EwoudVV/pcb-vise/HARDWARE.md

# hardware for one vise

this is the hardware for the general-purpose vise with TPU edge grips. the optional ESC attachment has its own [extra parts list](hardware-esc.csv)

the standard parts come to $46.31, or about $70.13 delivered with estimated tax. individual links and prices are in [hardware.csv](hardware.csv). `Quantity` is what goes in the vise; `Buy_quantity` is what to order

| Part | Qty |
| --- | ---: |
| M5 x 35 socket cap screw DIN 912 | 8 |
| M5 washer, 10 mm OD x 1 mm | 8 |
| M5 nut DIN 934, 8 mm AF x 4 mm | 8 |
| M3 x 30 socket cap screw DIN 912 | 8 |
| M3 nut DIN 934, 5.5 mm AF x 2.4 mm | 12 |
| M4 x 12 socket cap screw DIN 912 | 4 |
| M4 nut DIN 934, 7 mm AF x 3.2 mm | 6 |
| M6 x 50 hex bolt DIN 933 | 2 |
| M6 washer, 12 mm OD x 1.6 mm | 2 |
| M6 nut DIN 934, 10 mm AF x 5 mm | 2 |
| 8 x 250 mm smooth steel rod | 2 |
| M4 x 50 socket cap screw DIN 912 | 2 |
| M4 washer, 9 mm OD x 0.8 mm | 2 |
| Steel ballast, 38.1 x 60 x 19.05 mm | 4 |
| M3 x 20 socket cap screw DIN 912 | 4 |

## optional ESC attachment

the two printed adapters need eight M3 x 25 screws, four extra M3 nuts and four M3 washers. the nuts already fitted in the jaws are reused. those extra fasteners cost $1.12 before shipping and tax

use the longer screws with the ESC adapters. the standard edge grips use M3 x 20 screws

## check before ordering

use the nut sizes below. taller nuts, including Nylocs, won't fit the pockets

| Nut | Across flats | Height | Pocket across flats |
| --- | ---: | ---: | ---: |
| M3 | 5.5 mm | 2.4 mm | 5.8 mm |
| M4 | 7 mm | 3.2 mm | 7.3 mm |
| M5 | 8 mm | 4 mm | 8.3 mm |
| M6 | 10 mm | 5 mm | 10.3 mm |

the M5 pockets are only 4.4 mm deep, so a 4.7 mm tall nut won't work. check the actual hardware with the fit samples before printing all the parts. screw lengths are measured from under the head

## ballast

order four supplied-cut pieces of 3/4 x 1 1/2 inch 1018 steel bar, each 2.362 inches long (about 60 mm). the [custom-cut quote](https://www.onlinemetals.com/en/buy/carbon-steel/0-75-x-1-5-carbon-steel-rectangle-bar-1018-cold-finish/pid/9720) is $5.98 each

the supplier allows +1/8 inch and no undersize on the cut length. the liners now have 64 mm inside length and the foot pockets are 67 mm long, so pieces up to 63.17 mm fit. file any sharp burrs before fitting them. no sawing is planned

[ballast drawing](drawings/feet-and-ballast.svg) · [base calculation notes](DESIGN.md)

## references

- [DIN 934 nut dimensions](https://www.westfieldfasteners.co.uk/Standards/Nut_Hex_M.html)
- [DIN 912 cap screw dimensions](https://www.boltking.co.uk/din-912)
- [guide rod pair](https://www.walmart.com/ip/5057851455)

## prices checked October 15

| Order | Parts | Shipping | Tax | Total |
| --- | ---: | ---: | ---: | ---: |
| Bolt Depot standard fasteners | $7.90 | $7.33 | $0.49 | $15.72 |
| Online Metals, four cut weights | $23.92 | $13.59 | $1.50 | $39.01 |
| Walmart / Tasharina, rod pair | $14.49 | free | $0.91 estimated | $15.40 estimated |
| Total | $46.31 | $20.92 | $2.90 | $70.13 |

quotes use 01776 and residential shipping. Walmart shows free shipping but calculates tax at checkout; the $0.91 estimate uses [Massachusetts' 6.25% rate](https://www.mass.gov/guides/sales-and-use-tax)

one $5.98 weight is self-funded on the Half Life website, making its funding list $64.15. all four weights are required and are included in this file, the CSV and the cart

PETG-CF and TPU for AMS are already owned. the coupons tried did not lower the quoted total. nothing ordered yet
