EwoudVV/pcb-vise/exports/ballast-detail.png

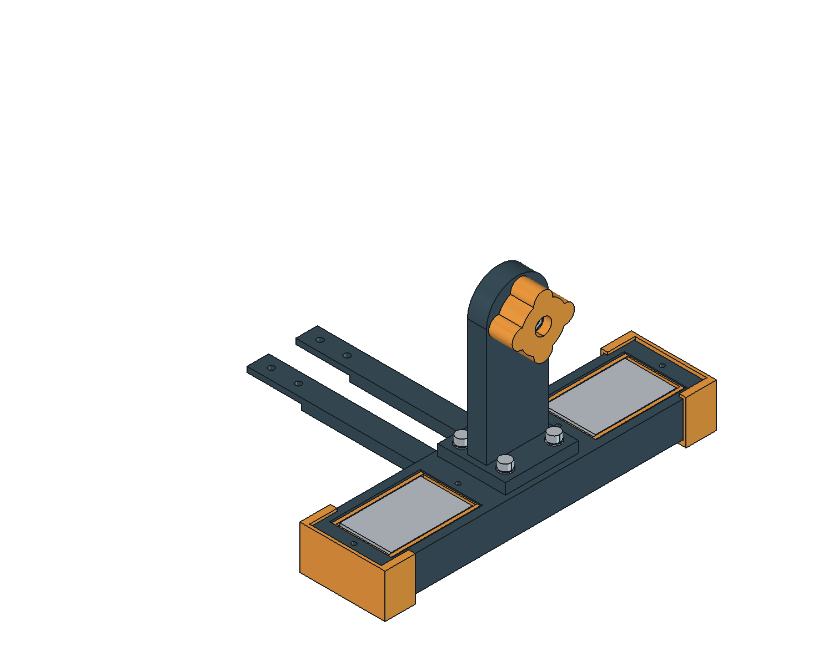
exports/ballast-detail.png
