EwoudVV/pcb-vise/exports/edge-grips.png

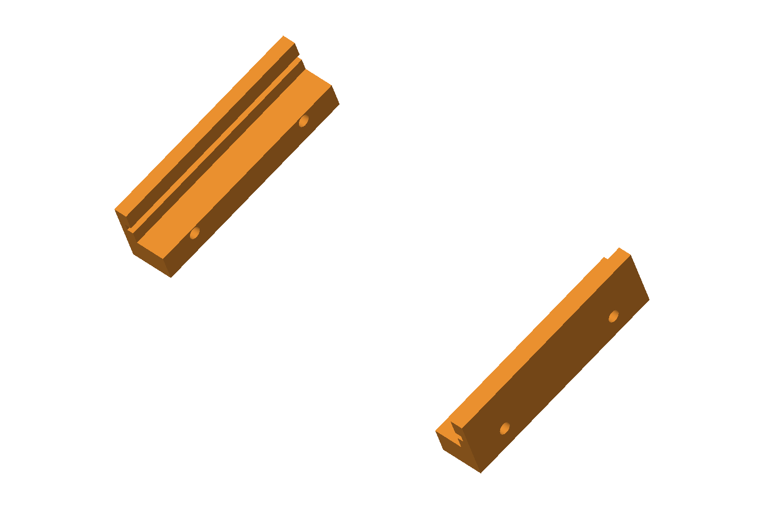
exports/edge-grips.png
