EwoudVV/pcb-vise/exports/underside-preview.png

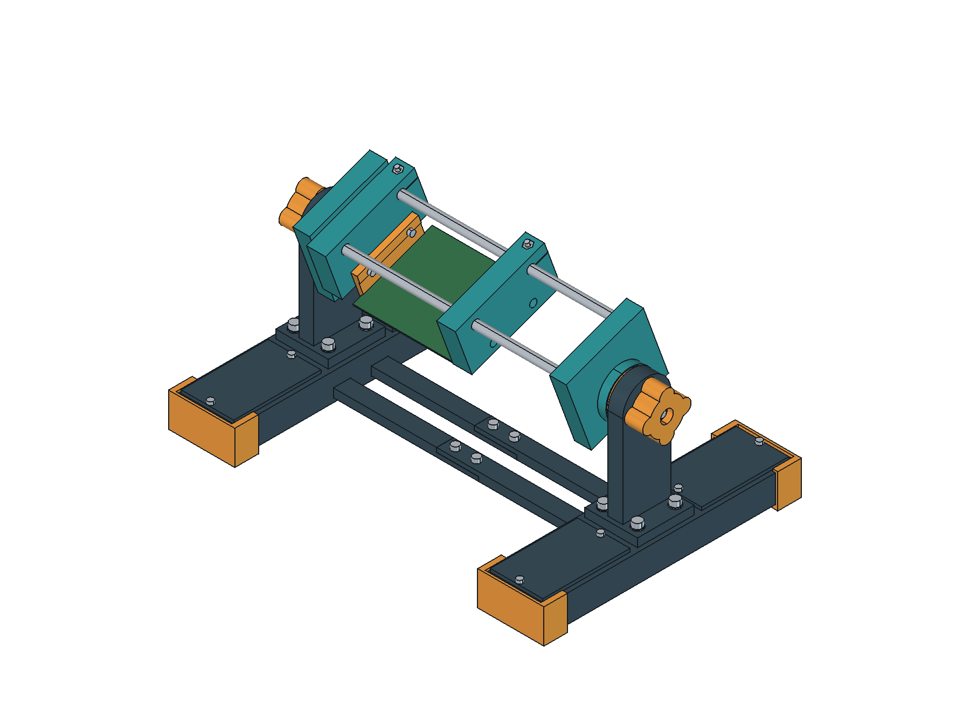
exports/underside-preview.png
