EwoudVV/pcb-vise/BOM.csv

Item | Qty | Supplier | Cost/item | Total Cost | link
M5 x 35 socket cap screw DIN 912 | 8 | Bolt Depot | $0.29 | $2.32 | https://boltdepot.com/Product-Details?product=6413
M5 washer, 10 mm OD x 1 mm | 8 | Bolt Depot | $0.05 | $0.40 | https://boltdepot.com/Product-Details?product=4515
M5 nut DIN 934, 8 mm AF x 4 mm | 8 | Bolt Depot | $0.07 | $0.56 | https://boltdepot.com/Product-Details?product=4775
M3 x 30 socket cap screw DIN 912 | 8 | Bolt Depot | $0.10 | $0.80 | https://boltdepot.com/Product-Details?product=6385
M3 nut DIN 934, 5.5 mm AF x 2.4 mm | 12 | Bolt Depot | $0.07 | $0.84 | https://boltdepot.com/Product-Details?product=4773
M4 x 12 socket cap screw DIN 912 | 4 | Bolt Depot | $0.09 | $0.36 | https://boltdepot.com/Product-Details?product=6394
M4 nut DIN 934, 7 mm AF x 3.2 mm | 6 | Bolt Depot | $0.07 | $0.42 | https://boltdepot.com/Product-Details?product=4774
M6 x 50 hex bolt DIN 933 | 2 | Bolt Depot | $0.45 | $0.90 | https://boltdepot.com/Product-Details?product=5971
M6 washer, 12 mm OD x 1.6 mm | 2 | Bolt Depot | $0.06 | $0.12 | https://boltdepot.com/Product-Details?product=4516
M6 nut DIN 934, 10 mm AF x 5 mm | 2 | Bolt Depot | $0.11 | $0.22 | https://boltdepot.com/Product-Details?product=4776
M4 x 50 socket cap screw DIN 912 | 2 | Bolt Depot | $0.29 | $0.58 | https://boltdepot.com/Product-Details?product=6404
M4 washer, 9 mm OD x 0.8 mm | 2 | Bolt Depot | $0.05 | $0.10 | https://boltdepot.com/Product-Details?product=4514
M3 x 20 socket cap screw DIN 912 | 4 | Bolt Depot | $0.07 | $0.28 | https://boltdepot.com/Product-Details?product=6383
8 x 250 mm steel guide rods, pair | 1 | Walmart / Tasharina Corp | $14.49 | $14.49 | https://www.walmart.com/ip/5057851455
Steel ballast blocks (3 funded of 4) | 3 | Online Metals | $5.98 | $17.94 | https://www.onlinemetals.com/en/buy/carbon-steel/0-75-x-1-5-carbon-steel-rectangle-bar-1018-cold-finish/pid/9720
Estimated total shipping | 1 |  |  | $23.82
