EwoudVV/pcb-vise/cad/pcb-vise-edge-grips.FCStd

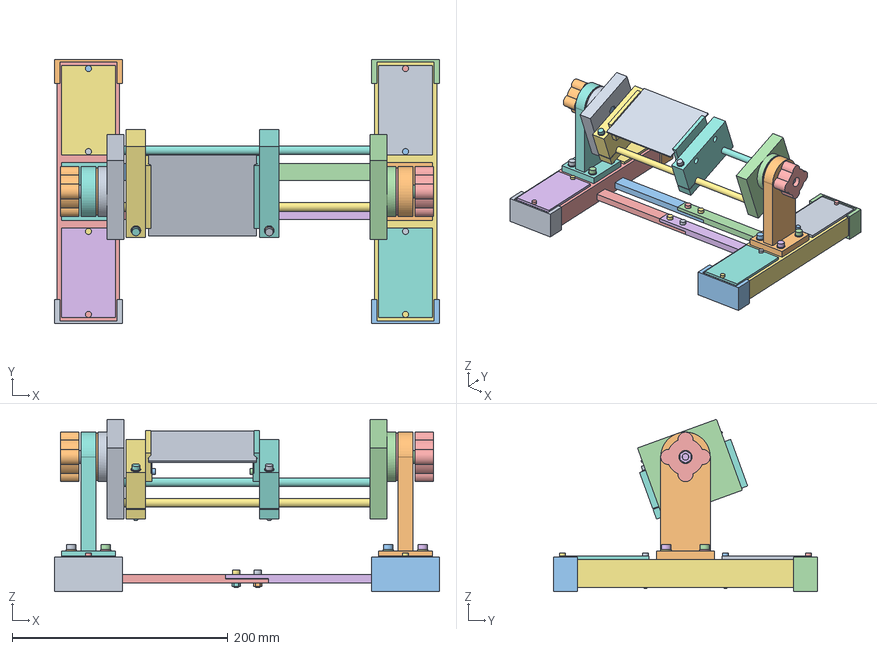
[picture p6: CAD file, 2026-10-15]
cad/pcb-vise-edge-grips.FCStd
357.0 x 245.0 x 160.0 mm
LeftBaseScrew0
LeftBaseWasher0
LeftBaseNut0
LeftBaseScrew1
LeftBaseWasher1
LeftBaseNut1
LeftBaseScrew2
LeftBaseWasher2
LeftBaseNut2
LeftBaseScrew3
LeftBaseWasher3
LeftBaseNut3
LeftLidScrew_114
LeftLidNut_114
LeftLidScrew_37
LeftLidNut_37
LeftLidScrew37
LeftLidNut37
LeftLidScrew114
LeftLidNut114
LeftFoot
LeftFrontBallastLid
LeftRearBallastLid
LeftUpright
LeftFrontShoe
LeftRearShoe
RightBaseScrew0
RightBaseWasher0
RightBaseNut0
RightBaseScrew1
RightBaseWasher1
RightBaseNut1
RightBaseScrew2
RightBaseWasher2
RightBaseNut2
RightBaseScrew3
RightBaseWasher3
RightBaseNut3
RightLidScrew_114
RightLidNut_114
RightLidScrew_37
RightLidNut_37
RightLidScrew37
RightLidNut37
RightLidScrew114
RightLidNut114
RightFoot
RightFrontBallastLid
RightRearBallastLid
RightUpright
RightFrontShoe
RightRearShoe
LeftFrontTie
RightFrontTie
FrontJointScrew0
FrontJointNut0
FrontJointScrew1
FrontJointNut1
LeftRearTie
RightRearTie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
