EwoudVV/pcb-vise/exports/fit-tests/m3-m4-m5-fit.stl

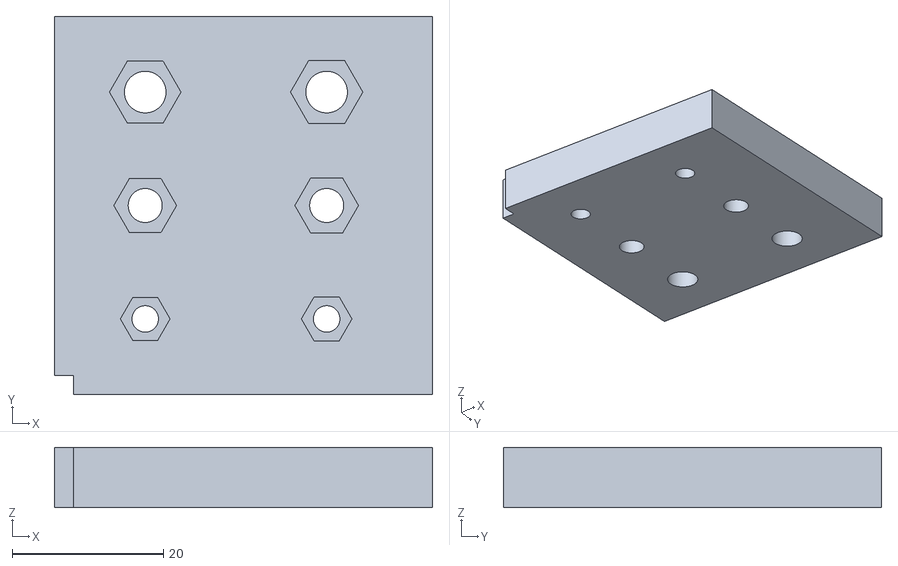
[picture p7: CAD file, 2026-10-14]
exports/fit-tests/m3-m4-m5-fit.stl
50.0 x 50.0 x 8.00
