EwoudVV/pcb-vise/exports/parts/LeftRearBallastLiner.stl

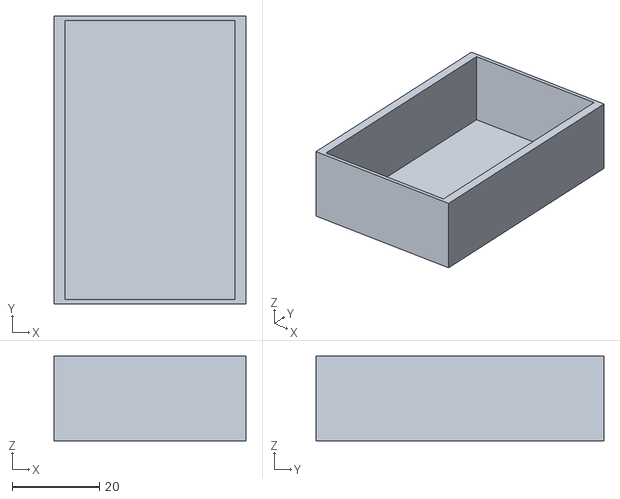
[picture p8: CAD file, 2026-10-15]
exports/parts/LeftRearBallastLiner.stl
44.0 x 66.0 x 19.5
