EwoudVV/pcb-vise/exports/print-plates/01-feet.3mf

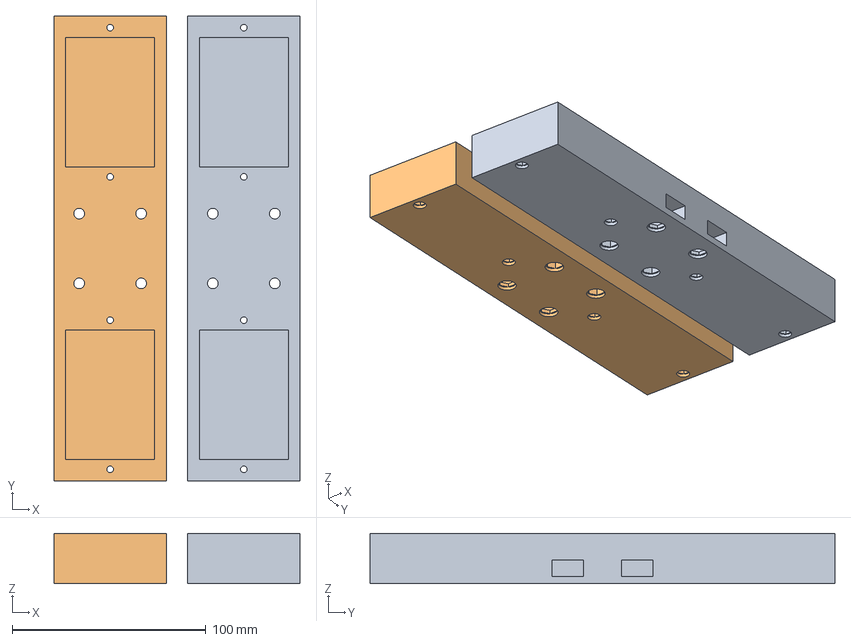
[picture p9: CAD file, 2026-10-15]
exports/print-plates/01-feet.3mf
127.0 x 240.0 x 26.0 mm
LeftFoot.stl
RightFoot.stl
