EwoudVV/pcb-vise/cad/fastener-fit.FCStd

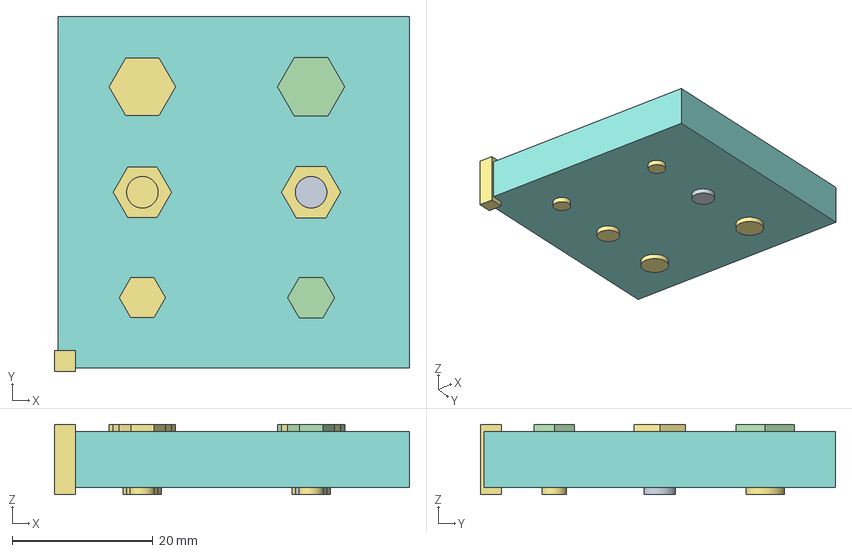
[picture p10: CAD file, 2026-10-14]
cad/fastener-fit.FCStd
50.5 x 50.5 x 10.0 mm
Blank
M3Pocket0
Clearance
M3Pocket1
Clearance001
M4Pocket0
Clearance002
M4Pocket1
Clearance003
M5Pocket0
Clearance004
M5Pocket1
Clearance005
CornerNotch
Pockets
FastenerFit
