EwoudVV/pcb-vise/exports/parts/LeftFoot.stl

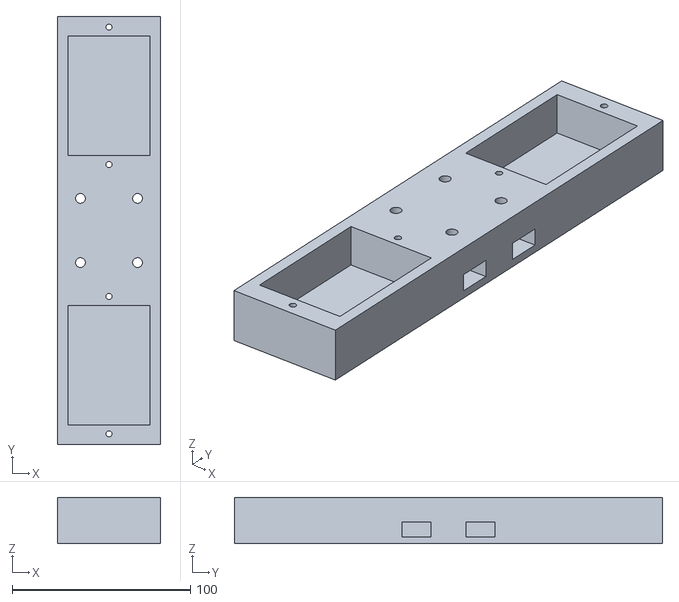
[picture p11: CAD file, 2026-10-15]
exports/parts/LeftFoot.stl
58.0 x 240.0 x 26.0
