EwoudVV/pcb-vise/exports/pcb-vise-esc.step

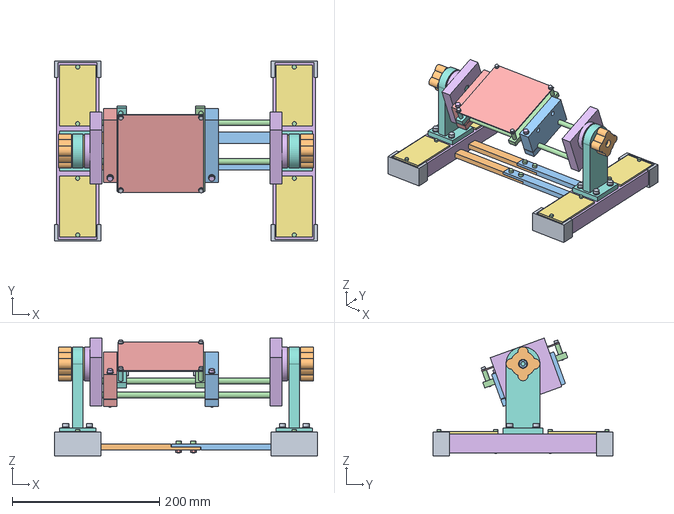
[picture p12: CAD file, 2026-10-15]
exports/pcb-vise-esc.step
357.0 x 245.0 x 160.0 mm
