EwoudVV/pcb-vise/exports/print-plates/06-tpu.3mf

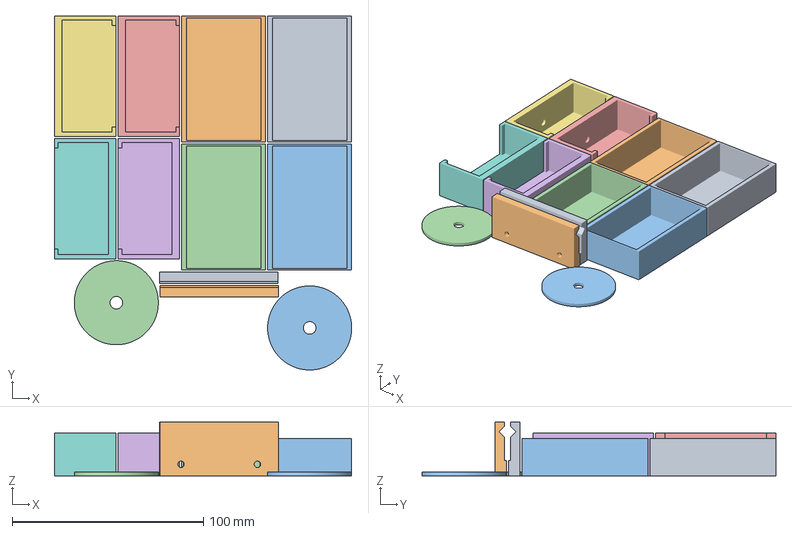
[picture p13: CAD file, 2026-10-15]
exports/print-plates/06-tpu.3mf
155.6 x 185.2 x 28.0 mm
LeftFrontBallastLiner.stl
LeftRearBallastLiner.stl
RightFrontBallastLiner.stl
RightRearBallastLiner.stl
LeftFrontShoe.stl
LeftRearShoe.stl
RightFrontShoe.stl
RightRearShoe.stl
FixedEdgeGrip.stl
SlidingEdgeGrip.stl
LeftFrictionRing.stl
RightFrictionRing.stl
