EwoudVV/pcb-vise/cad/fit-coupon.FCStd

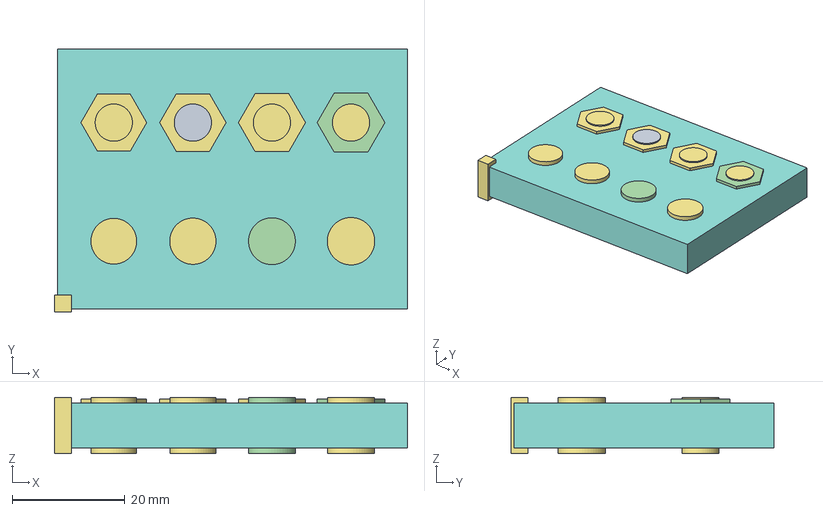
[picture p14: CAD file, 2026-10-12]
cad/fit-coupon.FCStd
62.5 x 46.5 x 10.0 mm
CouponBlank
RodHole0
RodHole1
RodHole2
RodHole3
NutPocket0
NutThroughHole0
NutPocket1
NutThroughHole1
NutPocket2
NutThroughHole2
NutPocket3
NutThroughHole3
CornerNotch
Cutouts
FitCoupon
