EwoudVV/pcb-vise/exports/pcb-vise-layout.step

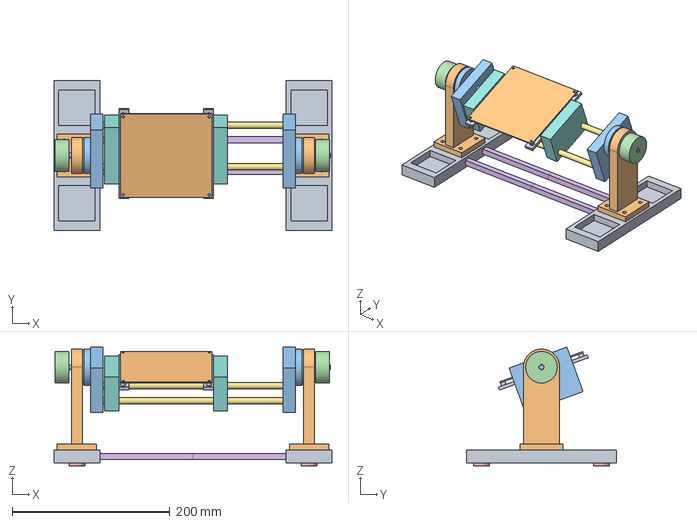
[picture p15: CAD file, 2026-10-12]
exports/pcb-vise-layout.step
352.0 x 190.0 x 150.6 mm
