EwoudVV/pcb-vise/exports/print-plates/07-optional-esc-adapters.3mf

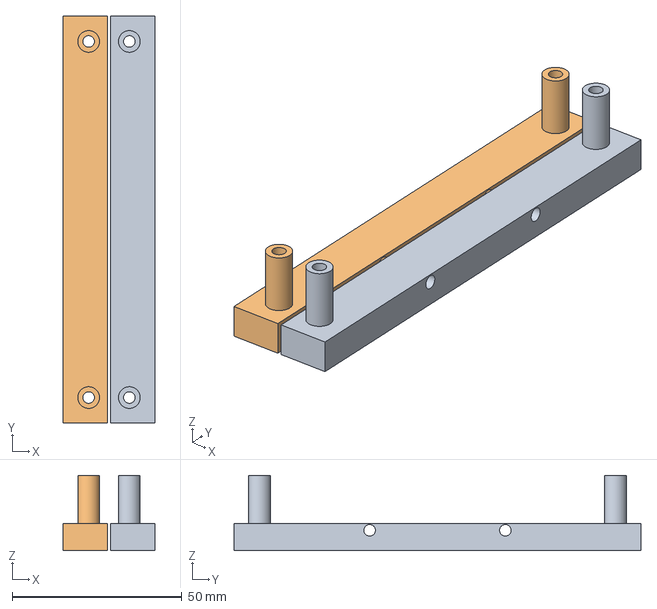
[picture p16: CAD file, 2026-10-15]
exports/print-plates/07-optional-esc-adapters.3mf
27.0 x 120.0 x 22.2 mm
FixedMountingAdapter.stl
SlidingMountingAdapter.stl
