EwoudVV/pcb-vise/exports/print-plates/03-base-bars.3mf

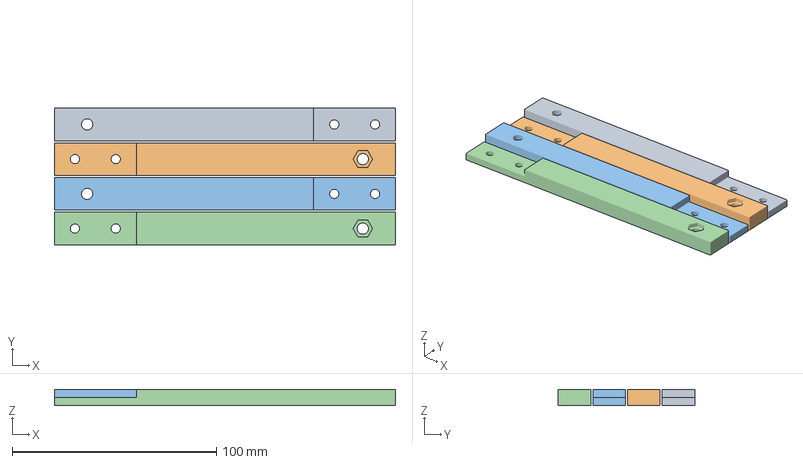
[picture p17: CAD file, 2026-10-15]
exports/print-plates/03-base-bars.3mf
167.0 x 67.0 x 8.00 mm
LeftFrontTie.stl
RightFrontTie.stl
LeftRearTie.stl
RightRearTie.stl
