EwoudVV/pcb-vise/exports/print-plates/05-lids.3mf

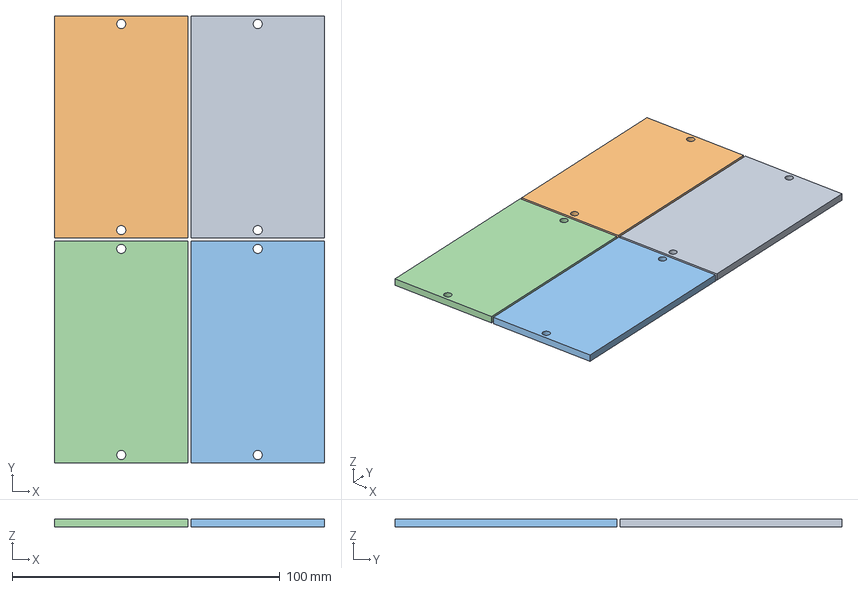
[picture p18: CAD file, 2026-10-15]
exports/print-plates/05-lids.3mf
101.0 x 167.0 x 3.00 mm
LeftFrontBallastLid.stl
LeftRearBallastLid.stl
RightFrontBallastLid.stl
RightRearBallastLid.stl
