EwoudVV/pcb-vise/exports/print-plates/04-jaws-and-pivots.3mf

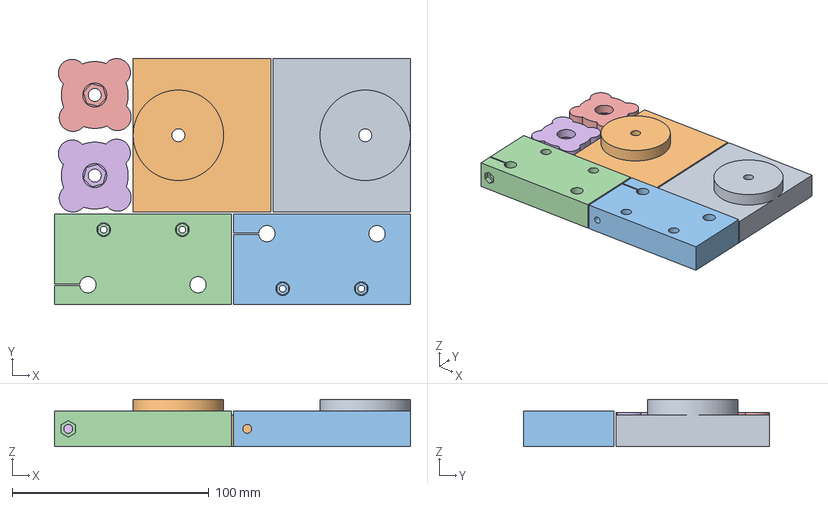
[picture p19: CAD file, 2026-10-15]
exports/print-plates/04-jaws-and-pivots.3mf
181.0 x 125.0 x 24.0 mm
LeftCarrier.stl
RightCarrier.stl
FixedJawBody.stl
SlidingJawBody.stl
LeftPivotKnob.stl
RightPivotKnob.stl
