EwoudVV/pcb-vise/exports/parts/SlidingEdgeGrip.stl

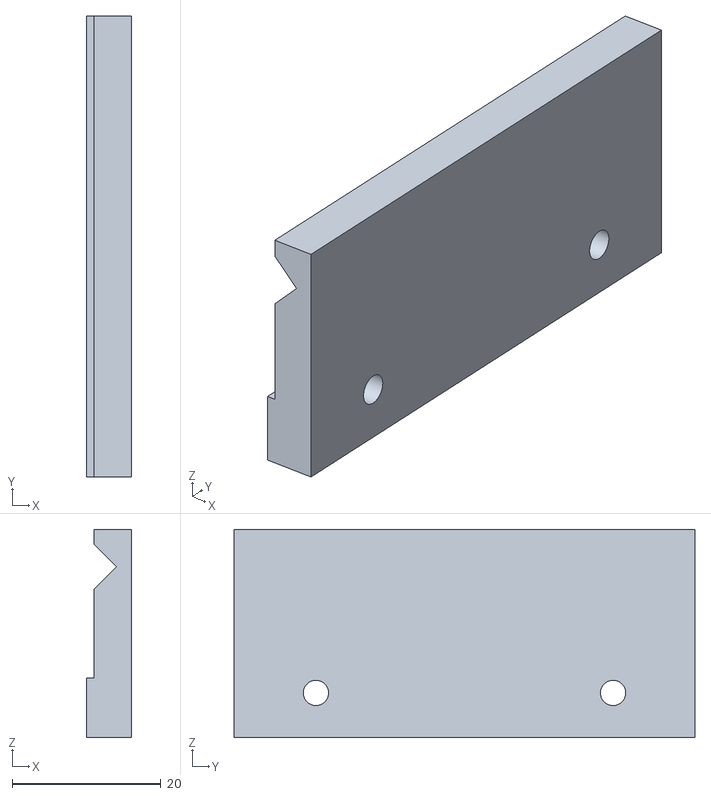
[picture p20: CAD file, 2026-10-15]
exports/parts/SlidingEdgeGrip.stl
6.00 x 62.0 x 28.0
