EwoudVV/pcb-vise/exports/print-plates/02-uprights.3mf

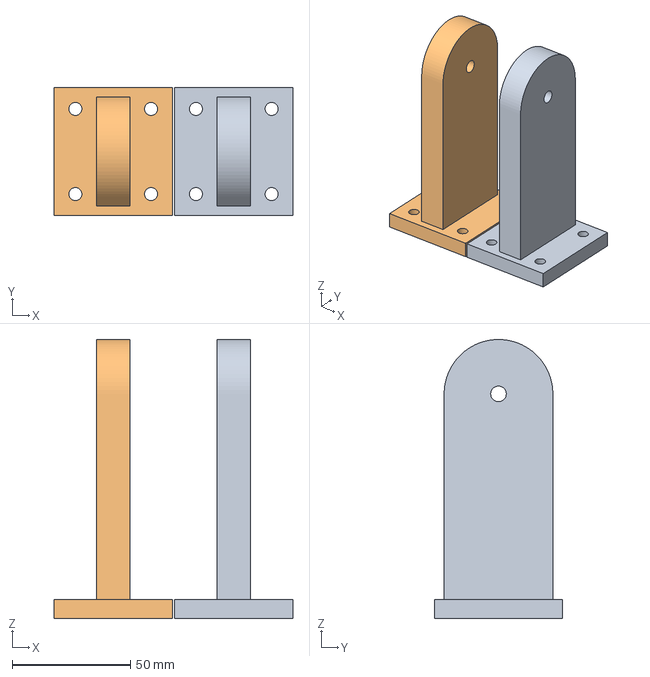
[picture p21: CAD file, 2026-10-15]
exports/print-plates/02-uprights.3mf
101.0 x 54.0 x 118.0 mm
LeftUpright.stl
RightUpright.stl
