EwoudVV/pcb-vise/exports/parts/RightRearTie.stl

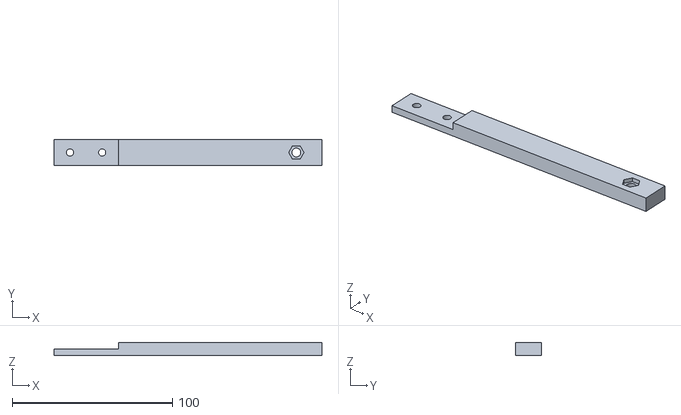
[picture p22: CAD file, 2026-10-15]
exports/parts/RightRearTie.stl
167.0 x 16.0 x 8.00
