EwoudVV/pcb-vise/exports/parts/LeftUpright.stl

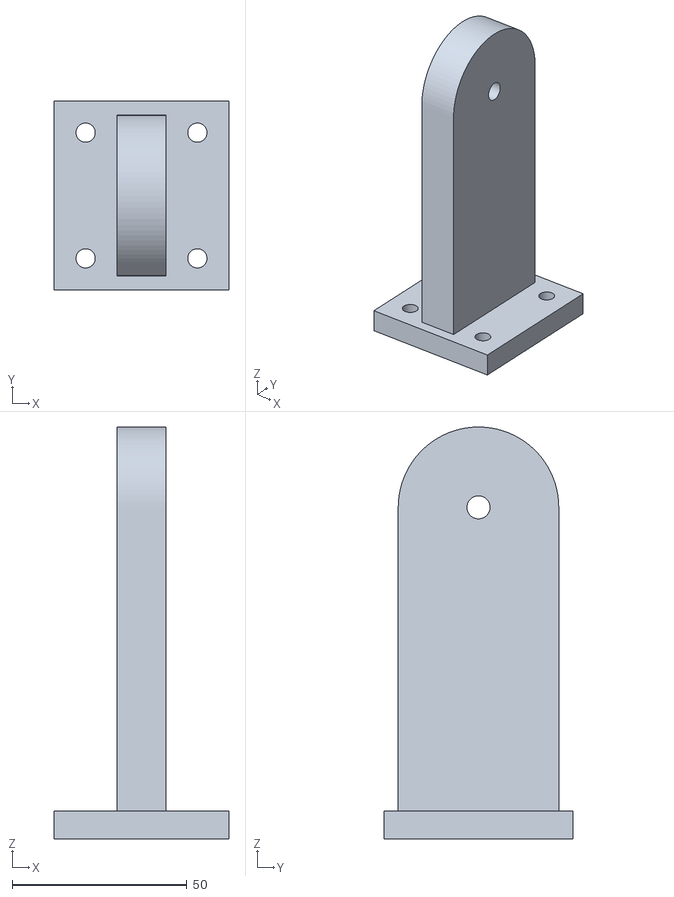
[picture p23: CAD file, 2026-10-15]
exports/parts/LeftUpright.stl
50.0 x 54.0 x 118.0
