EwoudVV/pcb-vise/exports/parts/RightFrontBallastLid.stl

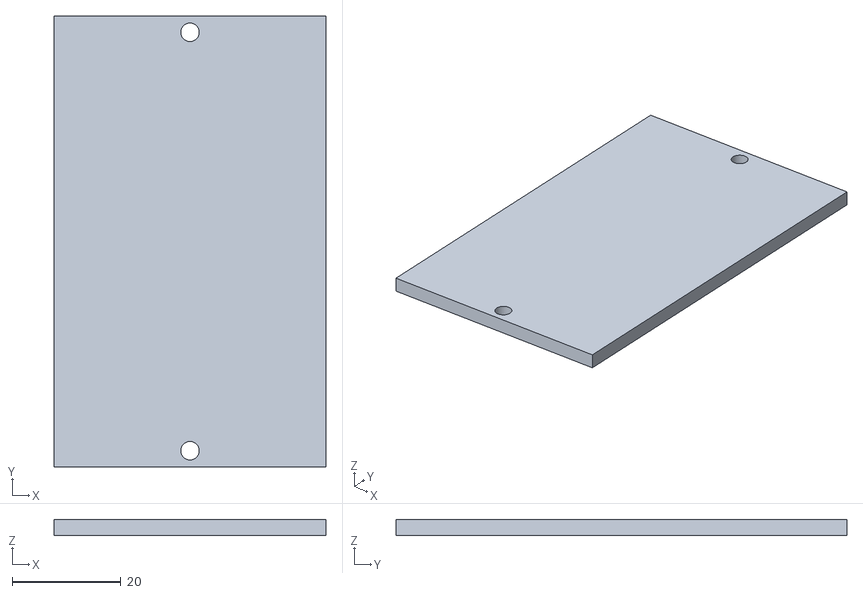
[picture p24: CAD file, 2026-10-15]
exports/parts/RightFrontBallastLid.stl
50.0 x 83.0 x 3.00
