EwoudVV/pcb-vise/exports/parts/RightRearShoe.stl

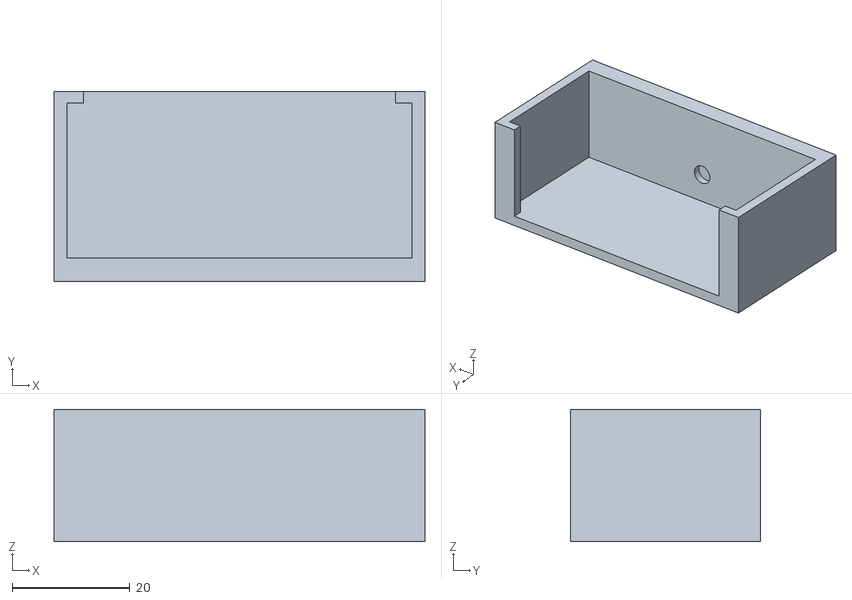
[picture p25: CAD file, 2026-10-15]
exports/parts/RightRearShoe.stl
63.0 x 32.3 x 22.5
