EwoudVV/pcb-vise/exports/parts/SlidingMountingAdapter.stl

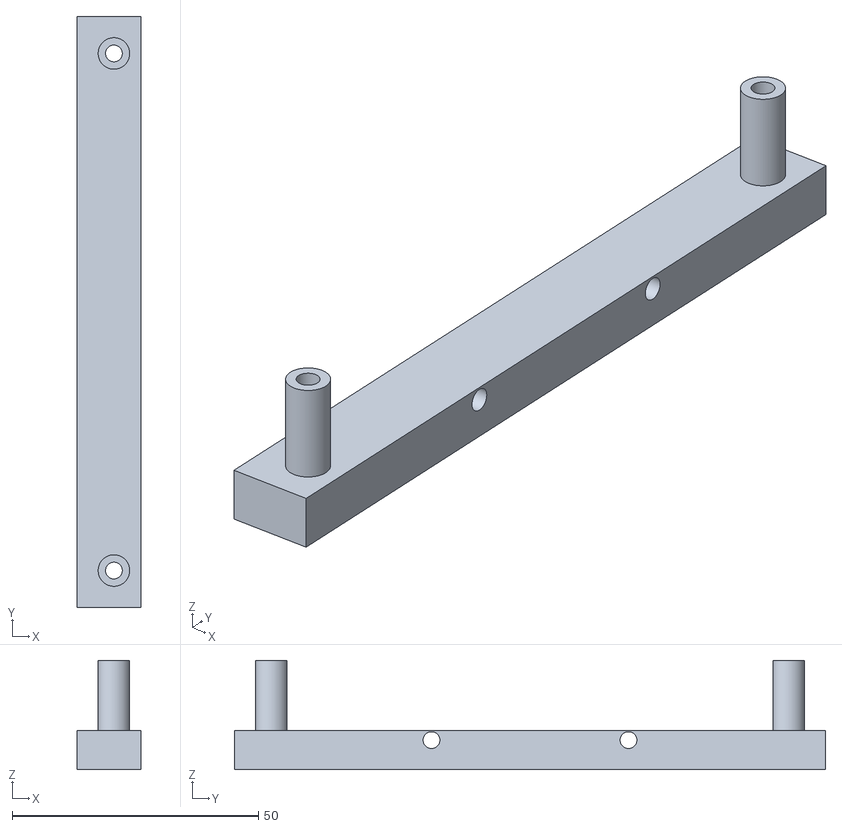
[picture p26: CAD file, 2026-10-15]
exports/parts/SlidingMountingAdapter.stl
13.0 x 120.0 x 22.2
