EwoudVV/pcb-vise/exports/parts/RightCarrier.stl

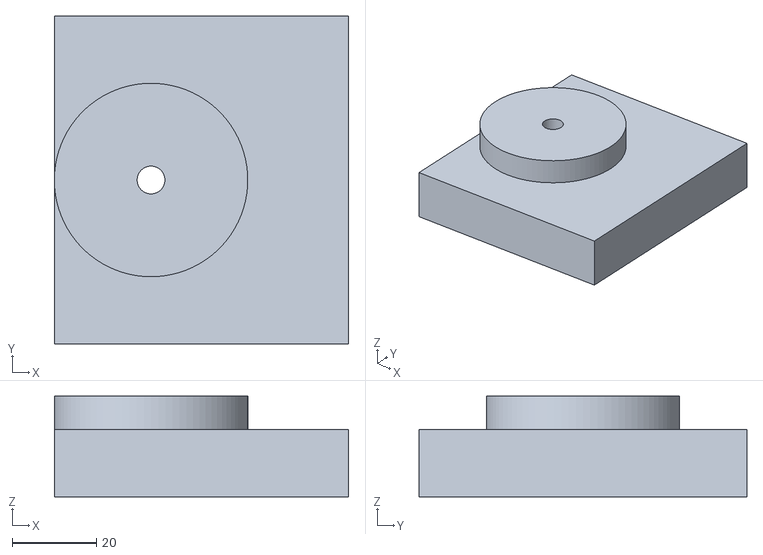
[picture p27: CAD file, 2026-10-14]
exports/parts/RightCarrier.stl
70.0 x 78.0 x 24.0
