EwoudVV/pcb-vise/exports/parts/FixedJawBody.stl

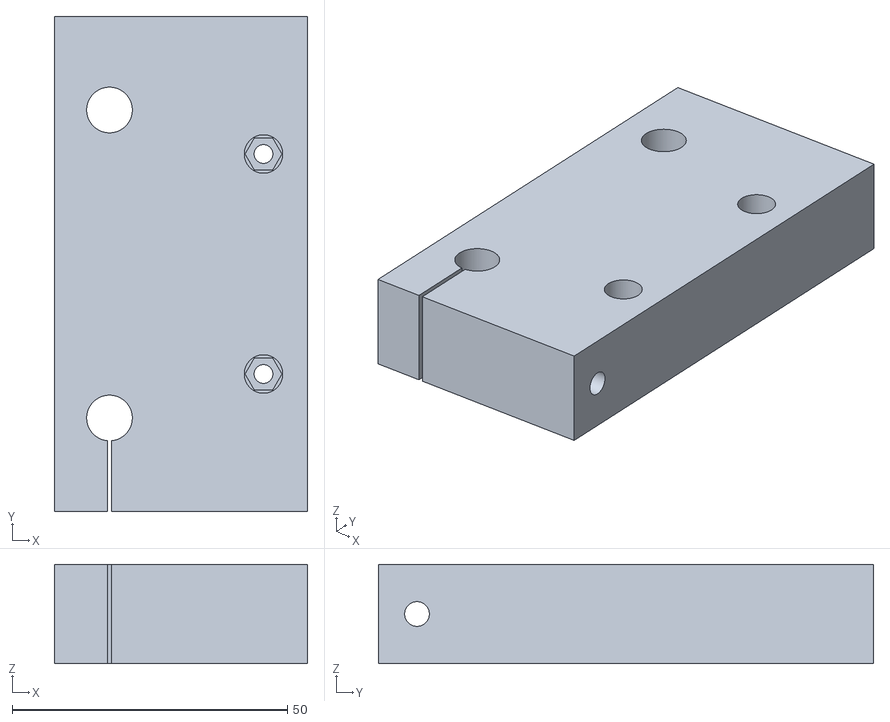
[picture p28: CAD file, 2026-10-14]
exports/parts/FixedJawBody.stl
46.0 x 90.0 x 18.0
