EwoudVV/pcb-vise/exports/parts/LeftPivotKnob.stl

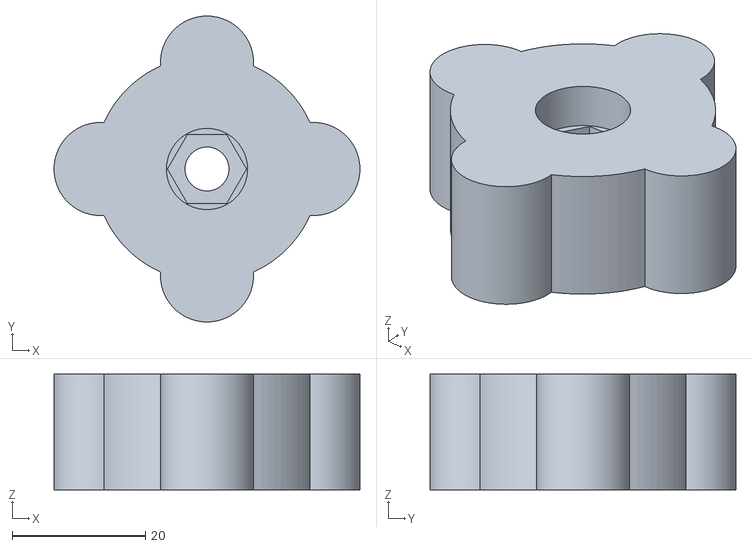
[picture p29: CAD file, 2026-10-14]
exports/parts/LeftPivotKnob.stl
46.0 x 46.0 x 17.4
