EwoudVV/pcb-vise/exports/parts/LeftFrictionRing.stl

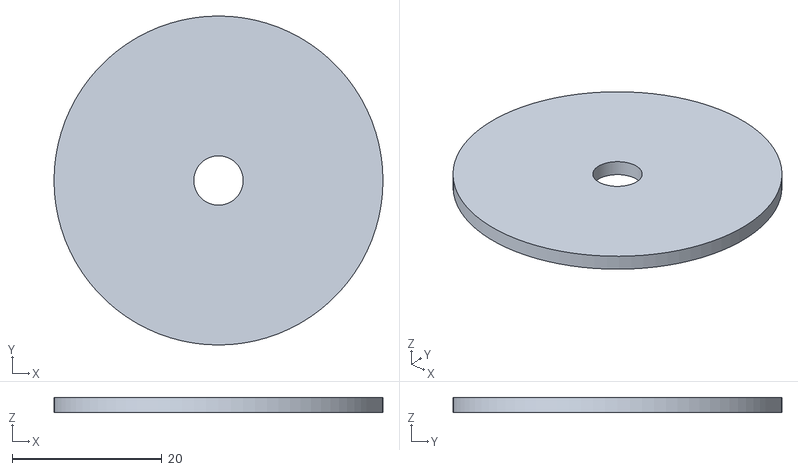
[picture p30: CAD file, 2026-10-14]
exports/parts/LeftFrictionRing.stl
44.0 x 44.0 x 2.00
