EwoudVV/pcb-vise/(list of files, cad)

Other CAD files:
exports/pcb-vise.step
exports/parts/RightFoot.stl
exports/parts/FixedEdgeGrip.stl
exports/parts/RightFrontTie.stl
exports/parts/LeftFrontShoe.stl
exports/parts/FixedMountingAdapter.stl
exports/parts/LeftRearShoe.stl
exports/parts/RightFrontShoe.stl
exports/parts/LeftFrontTie.stl
exports/parts/RightPivotKnob.stl
exports/parts/LeftRearTie.stl
exports/parts/LeftCarrier.stl
exports/parts/SlidingJawBody.stl
cad/pcb-vise-esc.FCStd
cad/pcb-vise-layout.FCStd
cad/pcb-vise.FCStd
exports/fit-tests/rod-and-nut-fit.stl
