EwoudVV/pcb-vise/exports/print-plates/README.md

# print plates

for my P1S with a 0.4 mm hardened-steel nozzle and textured PEI plate. plates 1-6 make the general-purpose vise. plate 7 is only for the optional ESC adapters

start with the fit samples and one grip pair during build week before printing the whole set

| Plate | Material | Time estimate | Filament |
| --- | --- | ---: | ---: |
| [01-feet](01-feet.3mf) | PETG-CF | 9h 36m | 296 g |
| [02-uprights](02-uprights.3mf) | PETG-CF | 3h 46m | 111 g |
| [03-base-bars](03-base-bars.3mf) | PETG-CF | 1h 57m | 57 g |
| [04-jaws-and-pivots](04-jaws-and-pivots.3mf) | PETG-CF | 7h 22m | 215 g |
| [05-lids](05-lids.3mf) | PETG-CF | 1h 27m | 48 g |
| [06-tpu](06-tpu.3mf) | TPU for AMS | 2h 48m | 118 g |
| [07-optional-esc-adapters](07-optional-esc-adapters.3mf) | PETG-CF | 0h 46m | 16 g |

about 727 g of PETG-CF and 118 g of TPU for the general-purpose vise. the ESC adapters add about 16 g of PETG-CF. these are slicer estimates, before fit samples or failed prints

the rigid parts use 0.20 mm layers, four walls and 30% gyroid infill. the TPU parts use three walls and 15% infill

only the feet have supports enabled. clean them out of the side slots and nut pockets before assembly. the right-hand base bars print top face down; the TPU grips print rail underside down

open a project, check the material and plate, then slice again before printing. nothing has been printed yet
