EwoudVV/pcb-vise/JOURNAL.md

# PCB Vise – devlog

<!-- Generated by Half Life from project cmv5uxwy90kuh01n00i6f4u88. Edits here are overwritten on the next sync. -->
<!-- Generated: 2026-10-15T20:52:27.979Z -->

> [!NOTE]
> This devlog is mirrored from [Half Life](https://halflife.hackclub.com) – [open the project](https://halflife.hackclub.com/projects/cmv5uxwy90kuh01n00i6f4u88). Editing it here will not change the platform's copy, and the next sync overwrites this file.

> a rotating pcb vise for soldering, with sliding jaws and replaceable V-groove grips for different board sizes and thicknesses. the frame flips over to reach both sides. also has an optional mounting-hole attachment for boards with crowded edges.

| Week | Tier | Hours logged | Entries |
| --- | --- | --- | --- |
| Week 2 | Tier 2 | 13h | 6 |

## Contents

1. [2026-10-12 – Devlog 01: first layout](#2026-10-12-devlog-01-first-layout)
2. [2026-10-14 – Devlog 02: clamps, pivots and base](#2026-10-14-devlog-02-clamps-pivots-and-base)
3. [2026-10-15 – Devlog 03: board clearance and ballast](#2026-10-15-devlog-03-board-clearance-and-ballast)
4. [2026-10-15 – Devlog 04: hardware and print setup](#2026-10-15-devlog-04-hardware-and-print-setup)
5. [2026-10-15 – Devlog 05: general-purpose grips](#2026-10-15-devlog-05-general-purpose-grips)
6. [2026-10-15 – Devlog 06: parts and submission prep](#2026-10-15-devlog-06-parts-and-submission-prep)

## Design

### 2026-10-12 – Devlog 01: first layout

**2h**

Devlog 01: first layout

started the pcb vise for CAD week. i want to hold a board while soldering and flip it over without taking it out

made the first layout in FreeCAD: a base, two uprights, and a frame with jaws that slide on steel rods. aiming for boards 30-160 mm wide. the main sizes are editable so i can adjust it as i go

looked at my ESC to work out how to hold it. there's too much stuff near the right edge for a normal grip, so i'm using its four mounting holes. i'll make separate grips for other boards

checked the frame at several angles and tried a few board sizes. nothing hit in this first layout, but it only has an empty board shape so far. still need to check the components and connectors

also made a small rod-hole and M6 nut-pocket sample for build week. i'll use that to choose the fit before printing the full parts

next are the jaw locks, pivot bolts and connections between the base pieces. nothing printed yet

layout-preview

fit-coupon-preview

### 2026-10-14 – Devlog 02: clamps, pivots and base

**4h**

Devlog 02: clamps, pivots and base

added the jaw locks. each jaw has a slit and an M4 screw that tightens it around the front rod with an Allen key

the ESC adapters now screw onto the jaws. also made TPU grips with slots for ordinary board edges. they use the same holes, so i can swap them without replacing the jaws

worked on the pivots too. M6 bolt heads sit in pockets in the carriers, and the knobs hold the nuts. TPU rings go between the frame and uprights to help hold the angle. i'll have to test how well that works when it's printed

the base pieces now bolt together. added lids for the weight pockets and TPU covers for the feet. found that the outer lid-screw tips hit the covers, so made recesses inside to clear them

checked for parts hitting each other as the frame turns and tried the jaws at different widths. also adjusted the print orientations and made a second fit sample for the smaller nuts

exported the STLs and STEP file, then updated the hardware list and assembly notes. nothing printed yet. the populated ESC clearance, base weight and remaining fits still need work before build week

mechanisms-preview

jaw-detail

base-detail

edge-grips

### 2026-10-15 – Devlog 03: board clearance and ballast

**2h**

Devlog 03: board clearance and ballast

checked the holder with the ESC components in place. some models were missing, including the XT60, so i left extra room around those parts

the power connector was too close to the fixed end of the holder. turned the ESC around so it faces the open space along the rods, and raised the adapters by 10 mm. the board screws are now M3 x 25

checked room for the connectors and a screwdriver, then checked clearance as the frame turns. the cable bends still need confirming. the normal edge grips stay at the original height

the old weight pockets were too small. made the feet longer and the pockets deeper, with TPU liners for four steel blocks. the blocks should weigh about 1.36 kg together

worked through the tipping calculation using just the steel blocks and rods. it gives a margin just over 1.5 for a 5 N sideways force at 225 mm above a flat bench. that still needs a real test, and it doesn't tell me whether the feet will slide

updated the lids and screws, added the drawings and changed the hardware list. next are prices, the remaining fits and a slicer review. printing comes during build week

esc-fit

ballast-detail

feet-drawing

adapter-drawing

### 2026-10-15 – Devlog 04: hardware and print setup

**3h**

Devlog 04: hardware and print setup

went through the hardware list and found actual parts for it. the standard M3 washers are a little wider than the ones i had modelled, and the M4 washers are thinner. changed those and checked the ESC again. the larger washers still clear the available component models

checked the screw lengths and nut pockets too. found cheaper rods at $5.79 each, and put all the screws, nuts and washers in one cart. that order is $8.74 before shipping. the full parts list is $39.92 before shipping, tax and cutting the steel

set up the print plates for my P1S and 0.4 mm hardened nozzle. the first slice caught two problems: the right-hand base bars had ledges hanging in the air, and the feet had unsupported roofs over the bar slots. flipped the right bars and added supports in the feet

the revised plates slice without warnings. saved six Bambu Studio projects with the materials and settings included, then reopened and sliced those to check they saved properly. the full set is about 749 g of PETG-CF and 115 g of TPU by the slicer estimate

updated the CAD, STEP, STLs and hardware list. the fastener and steel carts have shipping estimates, but the rod store isn't loading properly yet. still need that quote, a plan for cutting the steel and the last connector details. nothing printed or ordered

01-feet

03-bars-and-adapters

06-tpu

bolt-depot-shipping

### 2026-10-15 – Devlog 05: general-purpose grips

**1h**

Devlog 05: general-purpose grips

went back to the ordinary edge grips instead of spending more time on the ESC adapter. the old fixed-width slots weren't a good fit for different board thicknesses

changed them to V grooves and raised the board to leave more space underneath. the first version still had wide rails under the edges, so narrowed those and changed the grip screws to M3 x 20

checked small and large boards, with thicknesses from 0.8 to 2.4 mm. also checked space for components on both sides, rotation and access underneath with a small straight tool shape. the grips need about 3 mm of clear board edge. their actual holding force still needs a printed test

made this the default CAD model, STEP file and README view. the ESC adapters now have their own assembly, print plate and extra hardware list. updated the grip drawing and assembly instructions too

the changed plates slice without warnings. reopened the saved projects and checked them again, then updated the Half Life description and cover to show the general-purpose version. nothing printed yet

mechanisms-preview

jaw-detail

edge-grip-drawing

### 2026-10-15 – Devlog 06: parts and submission prep

**1h**

Devlog 06: parts and submission prep

finished the hardware carts. the original rod supplier still wouldn't load, so found another pair with free shipping. changed the fastener cart to match the general-purpose grips

got a quote for the steel weights already cut to length. that avoids needing a saw at the makerspace. the supplier allows the cuts to be a little long, so enlarged the pockets and TPU liners to fit the longest allowed pieces. checked those in the assembly and updated the drawings, exports and print plates

the complete estimate is $70.13 delivered, including estimated tax on the rods. one weight is self-funded on the website, bringing its funding list to $64.15. the full repo BOM and cart still include all four weights

saved the cart screenshots and made a short vertical closing reel from the CAD renders. checked the saved print projects again after changing the pockets. the design files and submission materials are ready. fit samples, holding tests and assembly come during build week. nothing ordered or printed yet

ballast-drawing

website-bom

walmart-cart
