EwoudVV/pcb-vise/(commit log)

2026-10-12 start rotating pcb vise layout and fit samples
    [fit-coupon.FCStd, hardware-candidates.csv, pcb-vise-layout.FCStd, pcb-vise-layout.step, rod-and-nut-fit.stl]
2026-10-12 Sync PCB Vise from Half Life
2026-10-14 add jaw clamps, pivot locks and bolted base joints
    [FixedEdgeGrip.stl, FixedJawBody.stl, FixedMountingAdapter.stl, LeftCarrier.stl, LeftFoot.stl, LeftFrictionRing.stl, LeftFrontBallastLid.stl, LeftFrontShoe.stl]
2026-10-14 match hardware references to cad part names
    [hardware.csv]
2026-10-15 raise the esc mounts and add a heavier base
    [FixedMountingAdapter.stl, LeftFoot.stl, LeftFrontBallastLid.stl, LeftFrontBallastLiner.stl, LeftFrontShoe.stl, LeftRearBallastLid.stl, LeftRearBallastLiner.stl, LeftRearShoe.stl]
2026-10-15 match the hardware and set up print plates
    [01-feet.3mf, 02-uprights.3mf, 03-bars-and-adapters.3mf, 04-jaws-and-pivots.3mf, 05-lids.3mf, 06-tpu.3mf, RightFrontTie.stl, RightRearTie.stl]
2026-10-15 add hardware and print setup devlog
2026-10-15 make the edge grips the main vise setup
    [03-bars-and-adapters.3mf, 03-base-bars.3mf, 06-tpu.3mf, 07-optional-esc-adapters.3mf, FixedEdgeGrip.stl, SlidingEdgeGrip.stl, hardware-esc.csv, hardware.csv]
2026-10-15 finish the parts list and fit supplied-cut weights
    [01-feet.3mf, 06-tpu.3mf, LeftFoot.stl, LeftFrontBallastLiner.stl, LeftRearBallastLiner.stl, RightFoot.stl, RightFrontBallastLiner.stl, RightRearBallastLiner.stl]
2026-10-15 mark cad week submitted
